BenBausch/seat-ibiza-display-mount/out/preview_back.png

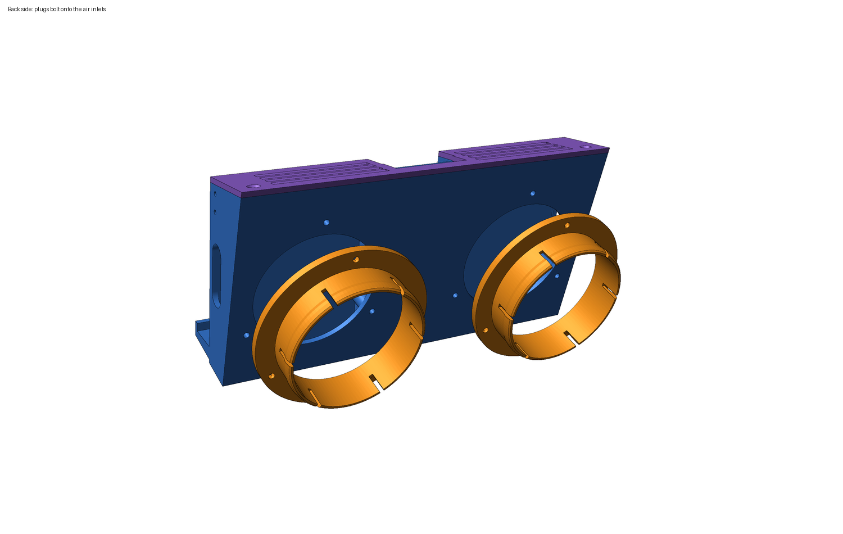
out/preview_back.png
