BenBausch/seat-ibiza-display-mount/out/preview_holder.png

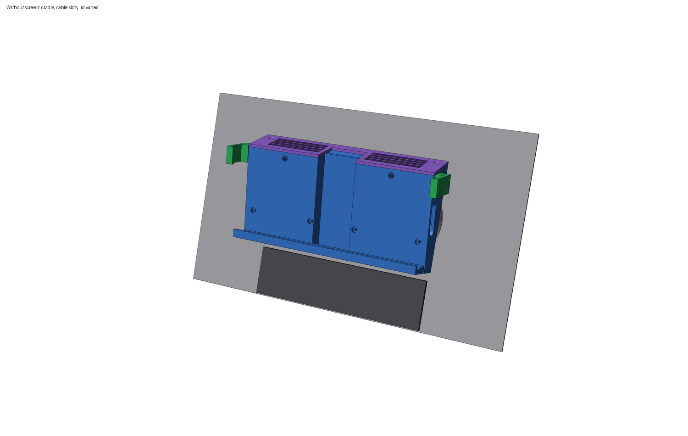
out/preview_holder.png
