BenBausch/seat-ibiza-display-mount/out/preview_small_parts.png

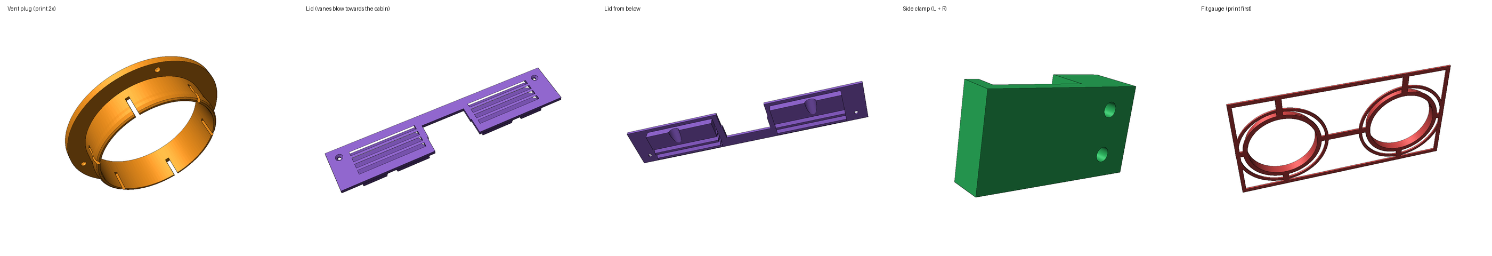
out/preview_small_parts.png
