BenBausch/seat-ibiza-display-mount/out/assembly.step

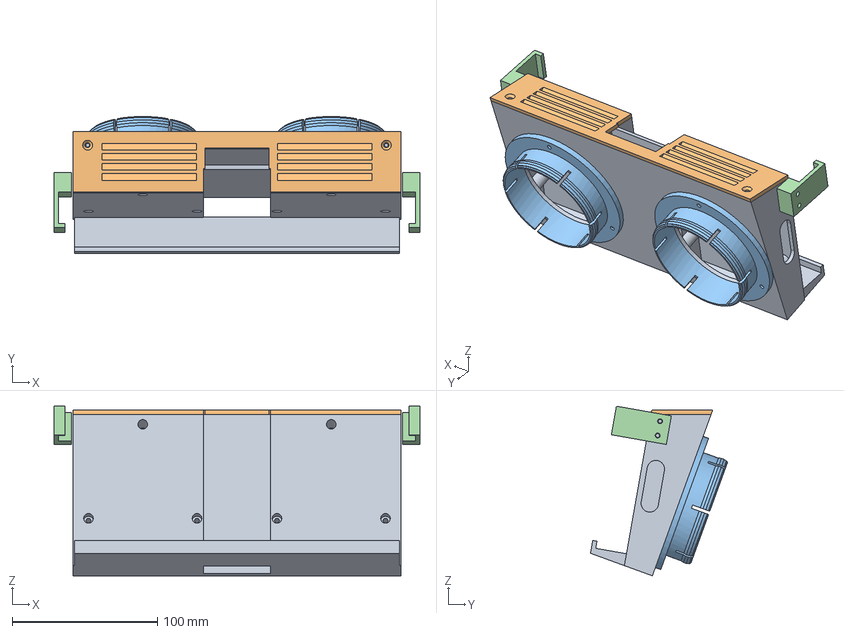
[picture p7: CAD file, 2026-11-11]
out/assembly.step
252.4 x 94.5 x 117.0 mm
