BenBausch/seat-ibiza-display-mount/out/ibiza_screen_holder.FCStd

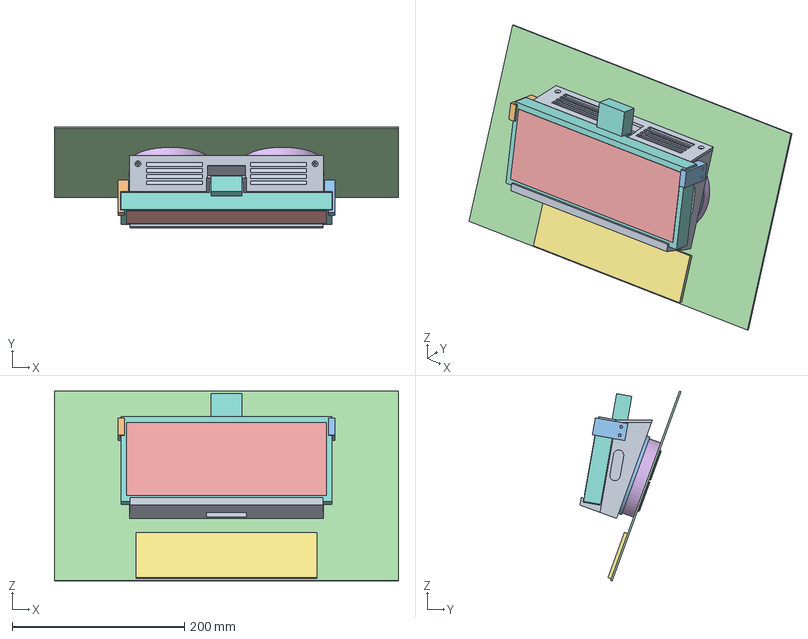
[picture p8: CAD file, 2026-11-11]
out/ibiza_screen_holder.FCStd
400.0 x 117.6 x 220.8 mm
Clamp_L
Clamp_R
Dummy_dash
Dummy_glass
Dummy_housings
Dummy_media
Dummy_screen
Lid
Plug_L
Plug_R
