BenBausch/seat-ibiza-display-mount/out/side_clamp_R.stl

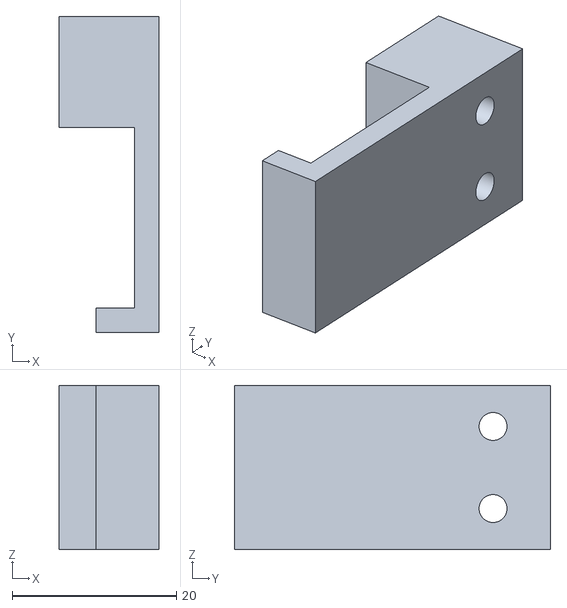
[picture p9: CAD file, 2026-11-11]
out/side_clamp_R.stl
12.2 x 38.5 x 20.0
