BenBausch/seat-ibiza-display-mount/out/gauge.step

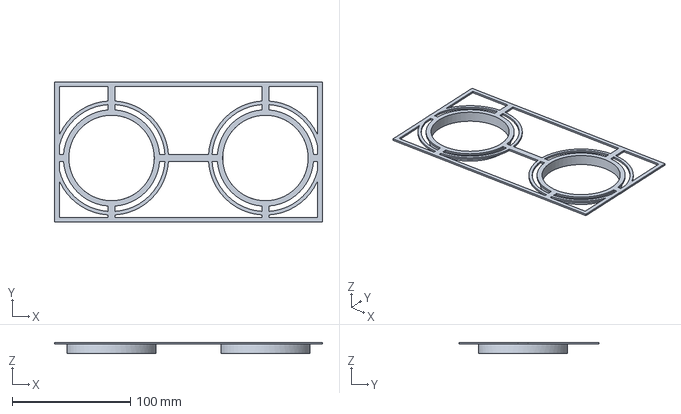
[picture p10: CAD file, 2026-11-11]
out/gauge.step
226.4 x 118.5 x 9.60 mm
