BenBausch/seat-ibiza-display-mount/out/lid.step

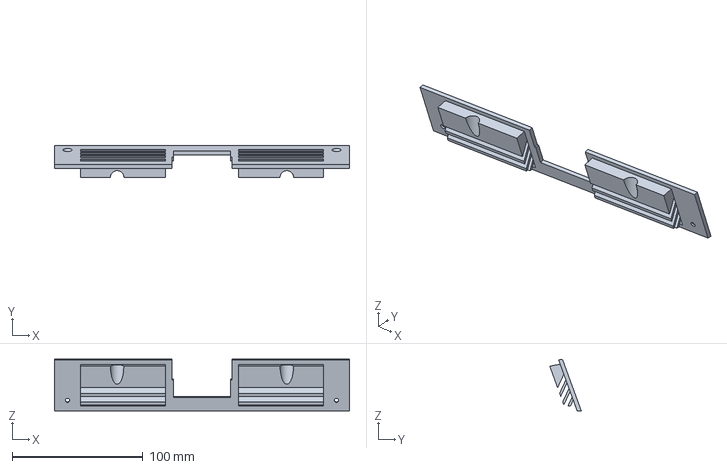
[picture p11: CAD file, 2026-11-11]
out/lid.step
226.0 x 24.2 x 39.5 mm
