BenBausch/seat-ibiza-display-mount/out/body.step

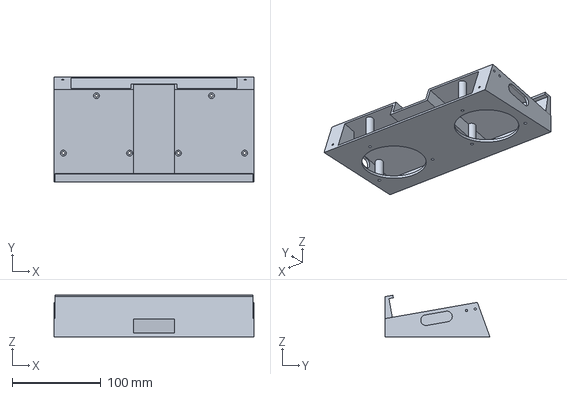
[picture p12: CAD file, 2026-11-11]
out/body.step
226.0 x 118.5 x 47.0 mm
