BenBausch/seat-ibiza-display-mount/out/vent_plug_x2.stl

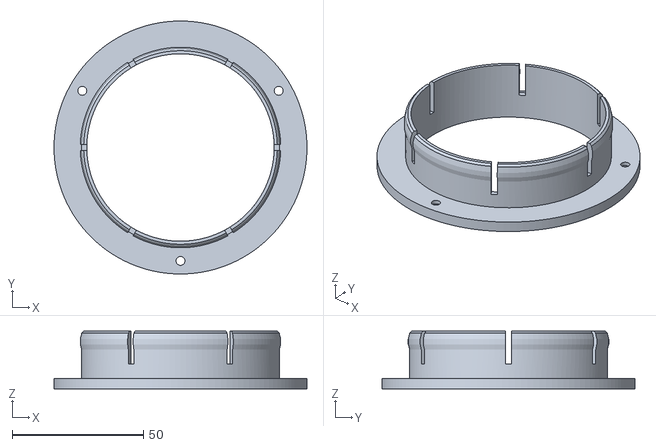
[picture p13: CAD file, 2026-11-11]
out/vent_plug_x2.stl
96.4 x 96.4 x 22.0
