BenBausch/seat-ibiza-display-mount/out/clamp_R.step

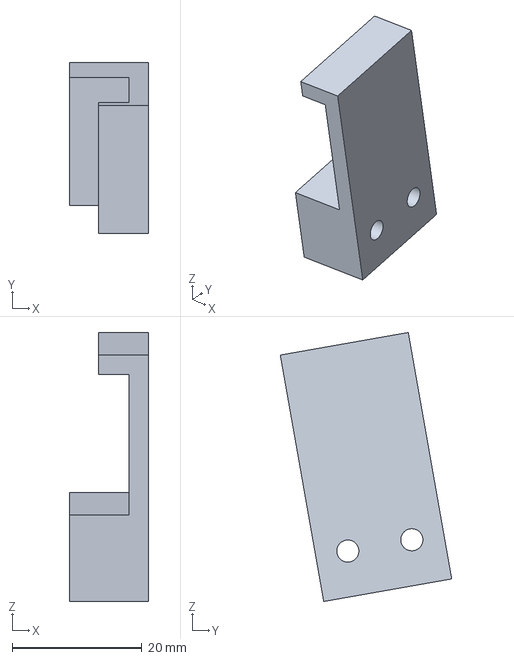
[picture p14: CAD file, 2026-11-11]
out/clamp_R.step
12.2 x 26.4 x 41.4 mm
