BenBausch/seat-ibiza-display-mount/(list of files, cad)

Other CAD files:
out/side_clamp_L.stl
out/fit_gauge.stl
out/plug.step
out/clamp_L.step
out/body.stl
out/lid.stl
